marekmajajaj/Inzynierka/kicad/inzynierka/inzynierka.kicad_pcb

## KiCad design kicad/inzynierka/inzynierka.kicad_pcb (2025-12-21)

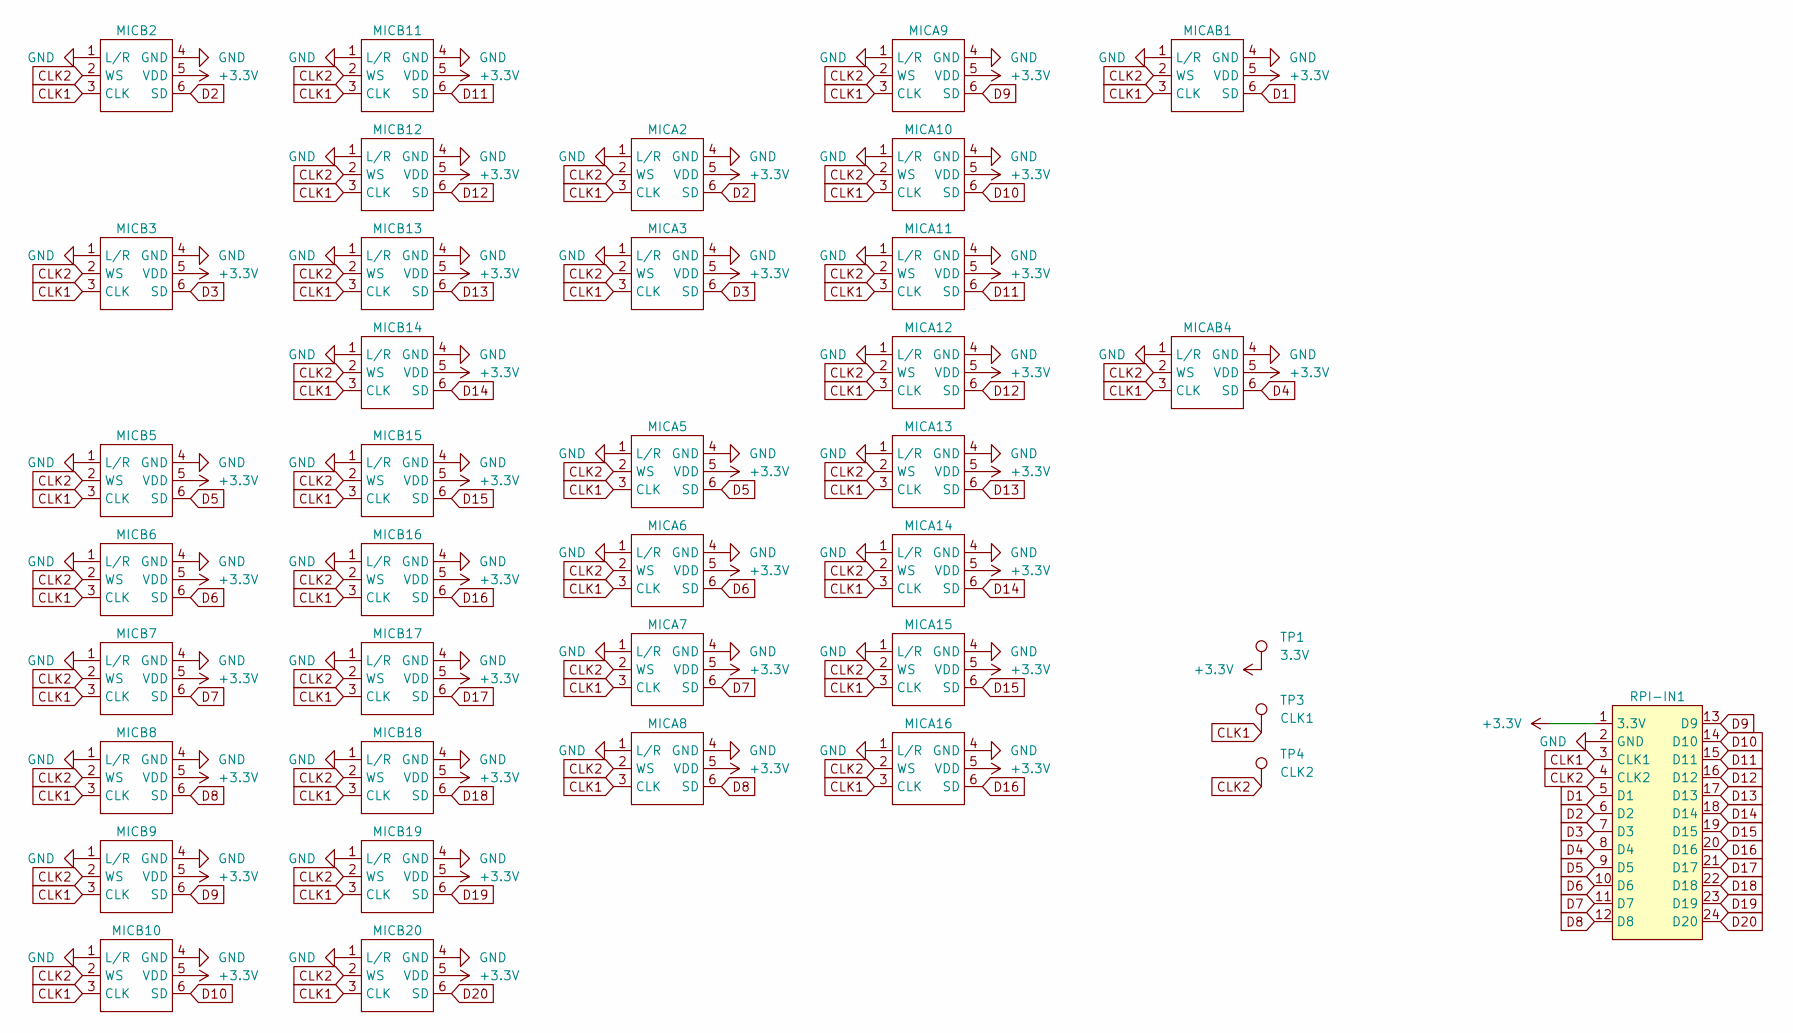
[picture p1: schematic inzynierka.kicad_sch]

Parts:
MICA2, MICA3, MICA5, MICA6, MICA7, MICA8, MICA9, MICA10, MICA11, MICA12, MICA13, MICA14, MICA15, MICA16: INMP441 breakout
MICAB1, MICAB4: INMP441 breakout
MICB2, MICB3, MICB5, MICB6, MICB7, MICB8, MICB9, MICB10, MICB11, MICB12, MICB13, MICB14, MICB15, MICB16, MICB17, MICB18, MICB19, MICB20: INMP441 breakout
RPI-IN1: RPI-IN1
TP1: 3.3V
TP3: CLK1
TP4: CLK2

Connections:
+3.3V: MICA2.5 (VDD), MICA3.5 (VDD), MICA5.5 (VDD), MICA6.5 (VDD), MICA7.5 (VDD), MICA8.5 (VDD), MICA9.5 (VDD), MICA10.5 (VDD), MICA11.5 (VDD), MICA12.5 (VDD), MICA13.5 (VDD), MICA14.5 (VDD), MICA15.5 (VDD), MICA16.5 (VDD), MICAB1.5 (VDD), MICAB4.5 (VDD), MICB2.5 (VDD), MICB3.5 (VDD), MICB5.5 (VDD), MICB6.5 (VDD), MICB7.5 (VDD), MICB8.5 (VDD), MICB9.5 (VDD), MICB10.5 (VDD), MICB11.5 (VDD), MICB12.5 (VDD), MICB13.5 (VDD), MICB14.5 (VDD), MICB15.5 (VDD), MICB16.5 (VDD), MICB17.5 (VDD), MICB18.5 (VDD), MICB19.5 (VDD), MICB20.5 (VDD), RPI-IN1.1 (3.3V), TP1.1; also elsewhere on the board
CLK1: MICA2.3 (CLK), MICA3.3 (CLK), MICA5.3 (CLK), MICA6.3 (CLK), MICA7.3 (CLK), MICA8.3 (CLK), MICA9.3 (CLK), MICA10.3 (CLK), MICA11.3 (CLK), MICA12.3 (CLK), MICA13.3 (CLK), MICA14.3 (CLK), MICA15.3 (CLK), MICA16.3 (CLK), MICAB1.3 (CLK), MICAB4.3 (CLK), MICB2.3 (CLK), MICB3.3 (CLK), MICB5.3 (CLK), MICB6.3 (CLK), MICB7.3 (CLK), MICB8.3 (CLK), MICB9.3 (CLK), MICB10.3 (CLK), MICB11.3 (CLK), MICB12.3 (CLK), MICB13.3 (CLK), MICB14.3 (CLK), MICB15.3 (CLK), MICB16.3 (CLK), MICB17.3 (CLK), MICB18.3 (CLK), MICB19.3 (CLK), MICB20.3 (CLK), RPI-IN1.3 (CLK1), TP3.1; also elsewhere on the board
CLK2: MICA2.2 (WS), MICA3.2 (WS), MICA5.2 (WS), MICA6.2 (WS), MICA7.2 (WS), MICA8.2 (WS), MICA9.2 (WS), MICA10.2 (WS), MICA11.2 (WS), MICA12.2 (WS), MICA13.2 (WS), MICA14.2 (WS), MICA15.2 (WS), MICA16.2 (WS), MICAB1.2 (WS), MICAB4.2 (WS), MICB2.2 (WS), MICB3.2 (WS), MICB5.2 (WS), MICB6.2 (WS), MICB7.2 (WS), MICB8.2 (WS), MICB9.2 (WS), MICB10.2 (WS), MICB11.2 (WS), MICB12.2 (WS), MICB13.2 (WS), MICB14.2 (WS), MICB15.2 (WS), MICB16.2 (WS), MICB17.2 (WS), MICB18.2 (WS), MICB19.2 (WS), MICB20.2 (WS), RPI-IN1.4 (CLK2), TP4.1; also elsewhere on the board
D1: MICAB1.6 (SD), RPI-IN1.5 (D1)
D2: MICA2.6 (SD), MICB2.6 (SD), RPI-IN1.6 (D2)
D3: MICA3.6 (SD), MICB3.6 (SD), RPI-IN1.7 (D3)
D4: MICAB4.6 (SD), RPI-IN1.8 (D4)
D5: MICA5.6 (SD), MICB5.6 (SD), RPI-IN1.9 (D5)
D6: MICA6.6 (SD), MICB6.6 (SD), RPI-IN1.10 (D6)
D7: MICA7.6 (SD), MICB7.6 (SD), RPI-IN1.11 (D7)
D8: MICA8.6 (SD), MICB8.6 (SD), RPI-IN1.12 (D8)
D9: MICA9.6 (SD), MICB9.6 (SD), RPI-IN1.13 (D9)
D10: MICA10.6 (SD), MICB10.6 (SD), RPI-IN1.14 (D10)
D11: MICA11.6 (SD), MICB11.6 (SD), RPI-IN1.15 (D11)
D12: MICA12.6 (SD), MICB12.6 (SD), RPI-IN1.16 (D12)
D13: MICA13.6 (SD), MICB13.6 (SD), RPI-IN1.17 (D13)
D14: MICA14.6 (SD), MICB14.6 (SD), RPI-IN1.18 (D14)
D15: MICA15.6 (SD), MICB15.6 (SD), RPI-IN1.19 (D15)
D16: MICA16.6 (SD), MICB16.6 (SD), RPI-IN1.20 (D16)
D17: MICB17.6 (SD), RPI-IN1.21 (D17)
D18: MICB18.6 (SD), RPI-IN1.22 (D18)
D19: MICB19.6 (SD), RPI-IN1.23 (D19)
D20: MICB20.6 (SD), RPI-IN1.24 (D20)
GND: MICA2.1 (L/R), MICA2.4 (GND), MICA3.1 (L/R), MICA3.4 (GND), MICA5.1 (L/R), MICA5.4 (GND), MICA6.1 (L/R), MICA6.4 (GND), MICA7.1 (L/R), MICA7.4 (GND), MICA8.1 (L/R), MICA8.4 (GND), MICA9.1 (L/R), MICA9.4 (GND), MICA10.1 (L/R), MICA10.4 (GND), MICA11.1 (L/R), MICA11.4 (GND), MICA12.1 (L/R), MICA12.4 (GND), MICA13.1 (L/R), MICA13.4 (GND), MICA14.1 (L/R), MICA14.4 (GND), MICA15.1 (L/R), MICA15.4 (GND), MICA16.1 (L/R), MICA16.4 (GND), MICAB1.1 (L/R), MICAB1.4 (GND), MICAB4.1 (L/R), MICAB4.4 (GND), MICB2.1 (L/R), MICB2.4 (GND), MICB3.1 (L/R), MICB3.4 (GND), MICB5.1 (L/R), MICB5.4 (GND), MICB6.1 (L/R), MICB6.4 (GND), MICB7.1 (L/R), MICB7.4 (GND), MICB8.1 (L/R), MICB8.4 (GND), MICB9.1 (L/R), MICB9.4 (GND), MICB10.1 (L/R), MICB10.4 (GND), MICB11.1 (L/R), MICB11.4 (GND), MICB12.1 (L/R), MICB12.4 (GND), MICB13.1 (L/R), MICB13.4 (GND), MICB14.1 (L/R), MICB14.4 (GND), MICB15.1 (L/R), MICB15.4 (GND), MICB16.1 (L/R), MICB16.4 (GND), MICB17.1 (L/R), MICB17.4 (GND), MICB18.1 (L/R), MICB18.4 (GND), MICB19.1 (L/R), MICB19.4 (GND), MICB20.1 (L/R), MICB20.4 (GND), RPI-IN1.2 (GND)

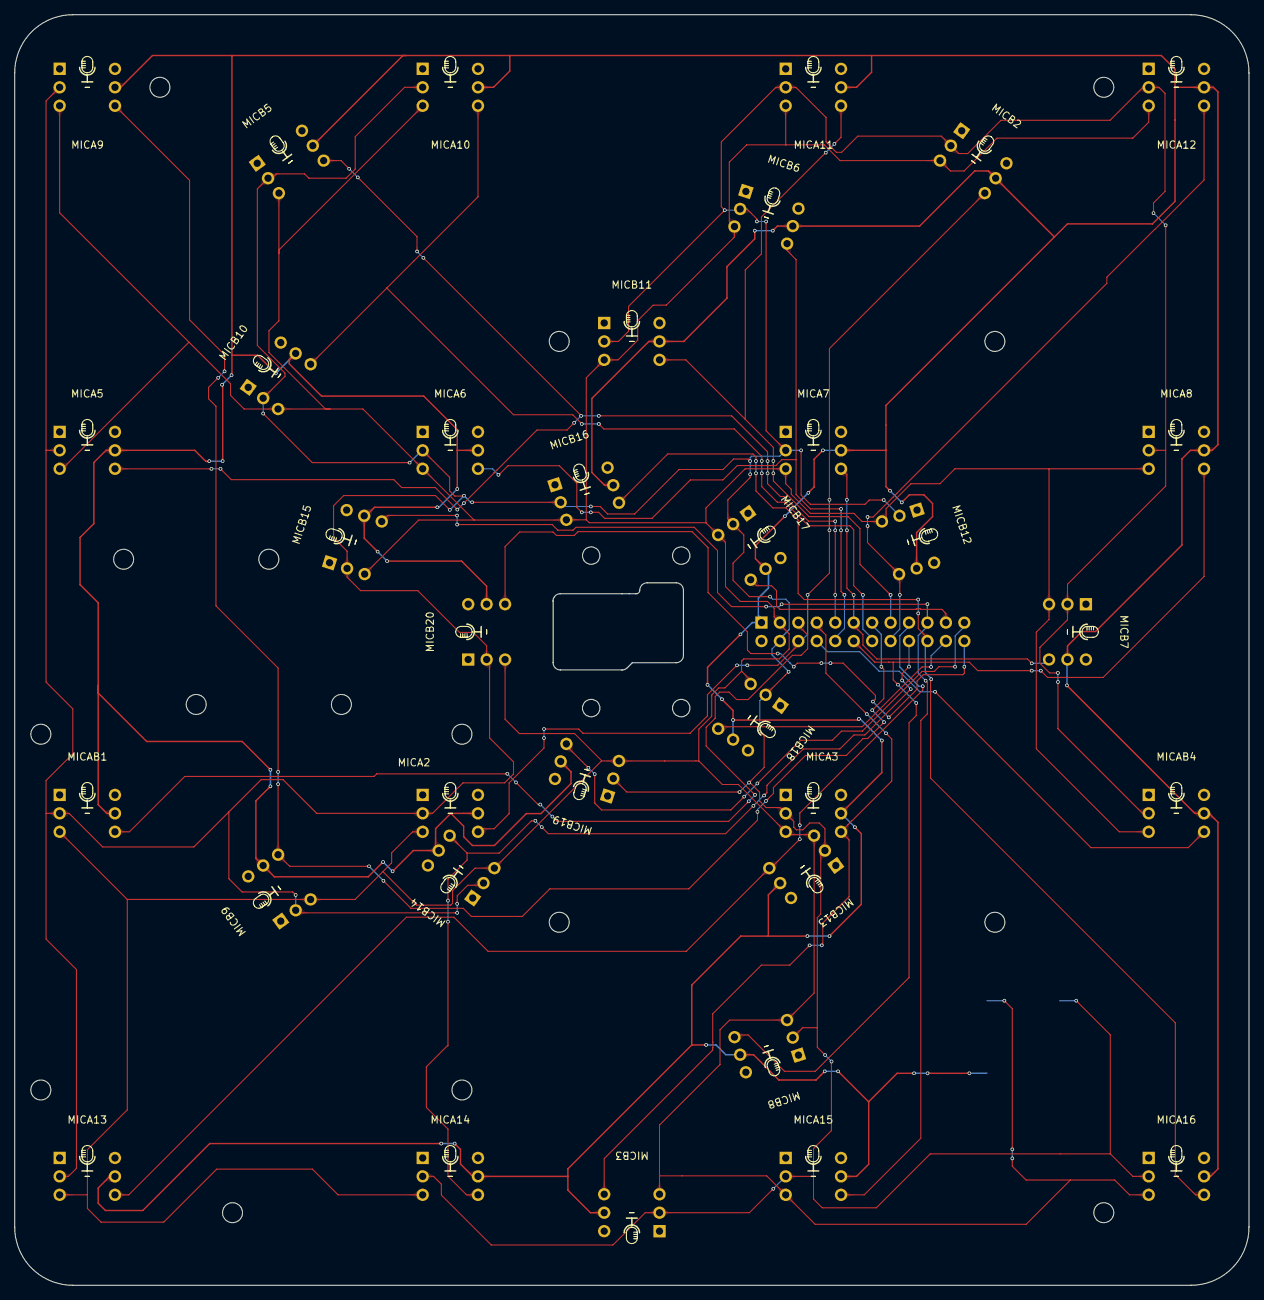
[picture p2: board inzynierka.kicad_pcb from above]

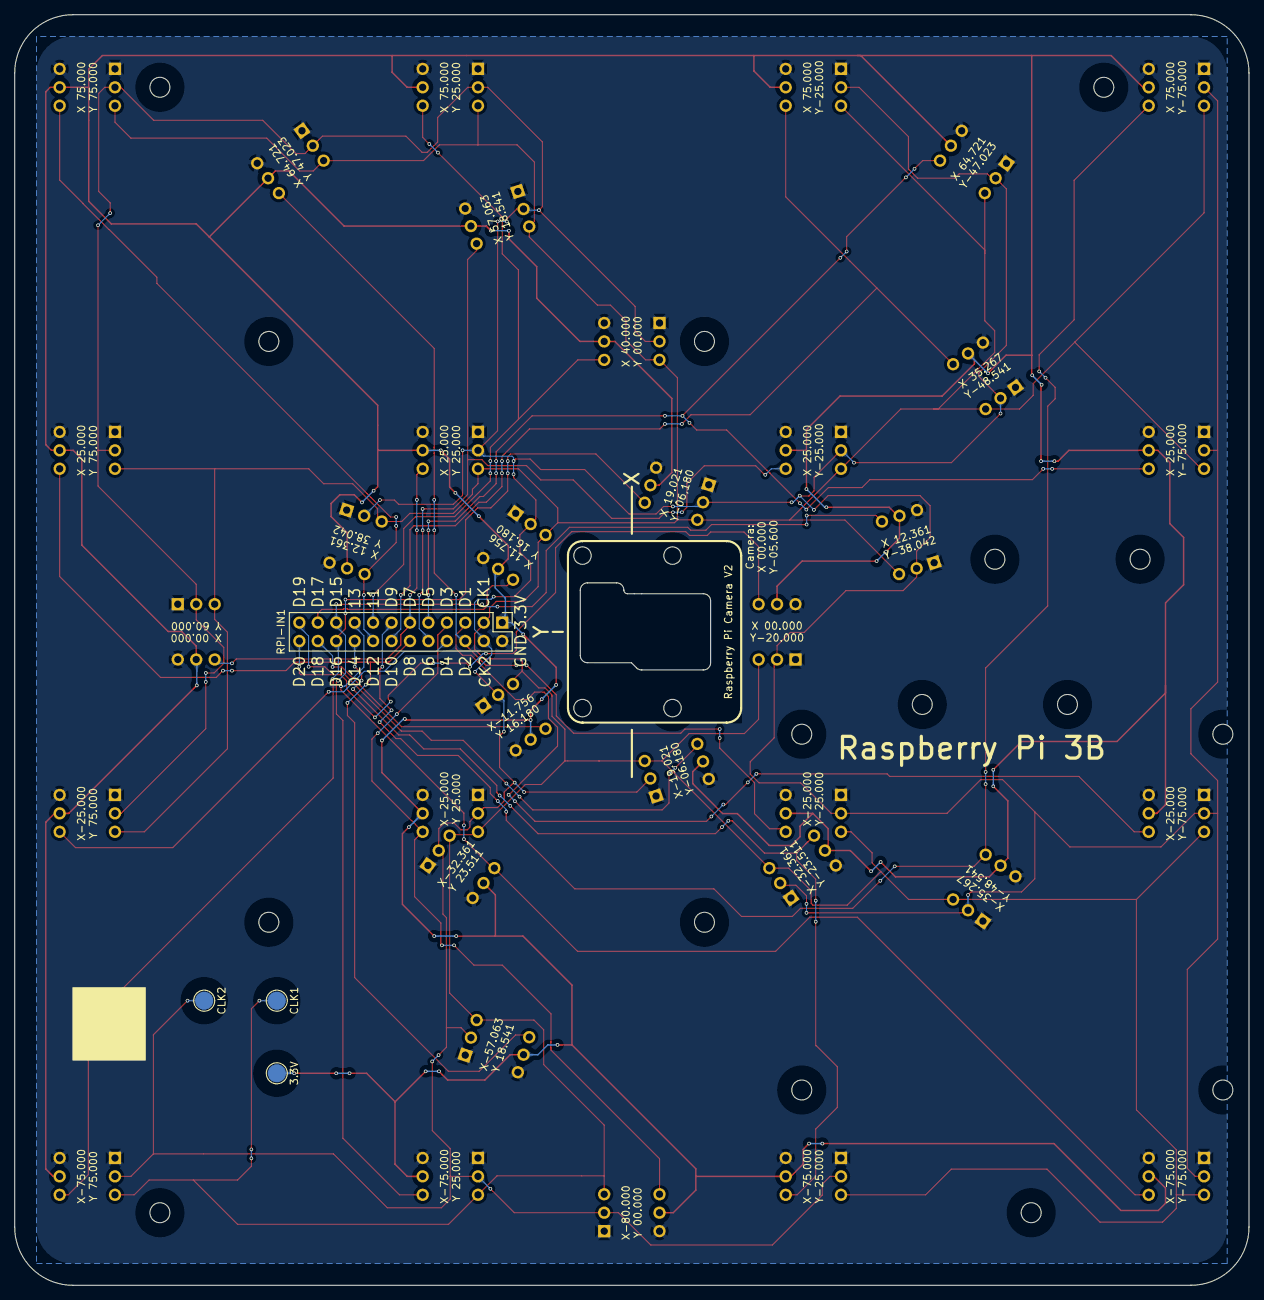
[picture p3: board inzynierka.kicad_pcb from below]

Board: 2 copper layers, 170.0 x 175.0 mm, 38 parts (4 on the bottom side), 24 nets.

Other parts of the board:
3.3V: 3.3V; TestPoint_Pad_D2.5mm
CLK1: CLK1; TestPoint_Pad_D2.5mm
CLK2: CLK2; TestPoint_Pad_D2.5mm

Their connections:
+3.3V: 3.3V.1; also elsewhere on the board
CLK1: CLK1.1; also elsewhere on the board
CLK2: CLK2.1; also elsewhere on the board
