marekmajajaj/Inzynierka/(commit log)

2025-12-13 Project start
    [inzynierka.kicad_pcb, inzynierka.kicad_sch]
2025-12-13 Przypisanie footprintów
    [inzynierka.kicad_sch]
2025-12-13 Added camera footprint
    [inzynierka.kicad_pcb]
2025-12-14 Started routing
    [inzynierka.kicad_pcb]
2025-12-14 Zmiana footprinta kamery
    [inzynierka.kicad_pcb]
2025-12-15 Zaktualizowano do KiCad 9.0
    [inzynierka.kicad_pcb, inzynierka.kicad_sch]
2025-12-15 Dodanie pozycji mikrofonów B
    [inzynierka.kicad_sch]
2025-12-15 Dodanie biblioteki footprintów do projektu
    [inzynierka.kicad_pcb, inzynierka.kicad_sch]
2025-12-15 Dodanie innego ustawienia głośników na płytkę
    [inzynierka.kicad_pcb, inzynierka.kicad_sch]
2025-12-15 Dodanie opisów do footprintów
    [inzynierka.kicad_pcb, inzynierka.kicad_sch]
2025-12-15 Dodanie minimalnych właściwości fizycznych
    [inzynierka.kicad_pcb]
2025-12-18 Coś tam porobione z płytką
    [inzynierka.kicad_pcb]
2025-12-19 Dodanie trasowania dla CLK1 i linii danych + rozpoczęcie trasowania CLK2
    [inzynierka.kicad_pcb]
2025-12-19 Dokończenie trasowania CLK2
    [inzynierka.kicad_pcb]
2025-12-19 Podłączenie L/R na głośnikach do GND
    [inzynierka.kicad_pcb, inzynierka.kicad_sch]
2025-12-20 Dokończenie trasowania 3.3V
    [inzynierka.kicad_pcb, inzynierka.kicad_sch]
2025-12-20 Usunięcie błędów DRC dla 3.3V
    [inzynierka.kicad_pcb]
2025-12-20 Uładnienie połączeń
    [inzynierka.kicad_pcb]
2025-12-20 Pogrubienie footprintów + poprawienie trasowania
    [inzynierka.kicad_pcb]
2025-12-20 Poprawa łączenia termicznego dla L/R w INMP441
    [inzynierka.kicad_pcb]
2025-12-21 Zaokrąglenie płytki
    [inzynierka.kicad_pcb]
2025-12-21 Dodanie dziur montażowych
    [inzynierka.kicad_pcb]
2025-12-21 Poprawienie footprintu i odwrócenie kamery
    [inzynierka.kicad_pcb]
2025-12-21 Przesunięto dziury montażowe dla RPI 3
    [inzynierka.kicad_pcb]
2025-12-21 Rozpoczęcie dodawania opisów z tyłu płytki
    [inzynierka.kicad_pcb]
2025-12-21 Dodanie podpisów lokalizacji mikrofonów
    [inzynierka.kicad_pcb]
2025-12-21 Sprawdzenie ścieżek
    [inzynierka.kicad_pcb]
2025-12-21 Dodanie oznaczenia na kod QR
    [inzynierka.kicad_pcb]
2025-12-21 Zmiana pozycji kodu QR
    [inzynierka.kicad_pcb]
2025-12-21 Zmniejszenie miedzi dla NTHP na kamerze
    [inzynierka.kicad_pcb]
2025-12-21 Ostatecznie poprawki, chyba
    [inzynierka.kicad_pcb]
2025-12-21 Poprawienie ograniczeń projektowych
    [inzynierka.kicad_pcb]
2025-12-21 Zwiększenie rozmiaru przelotek
    [inzynierka.kicad_pcb, inzynierka.kicad_sch]
2025-12-21 Dodanie padów testowych
    [inzynierka.kicad_pcb, inzynierka.kicad_sch]
2025-12-21 Poszerzenie ścieżek do 0.14mm
    [inzynierka.kicad_pcb]
2025-12-21 Poprawienie footprinta
    [inzynierka.kicad_pcb]
2026-01-05 Dodanie pobierania danych na opadajacy sygnal PWM
2026-01-05 Powrocenie do sposobu z DMA
2026-01-06 Naprawiono bloki kontrolen DMA i ustawiono dobrze timingi
2026-02-05 Heatmapa działa dobrze
